dselvan/open-sassy/README.md

# open-sassy
design and implementation of a slip angle sensor targeted for formula student electric controls applications
