dselvan/open-sassy/docs/notes.md

# Notes for documentation setup

- <https://learn.adafruit.com/the-well-automated-arduino-library/doxygen>
