dselvan/open-sassy/sensor_capture/img/white_a4_squal54.png

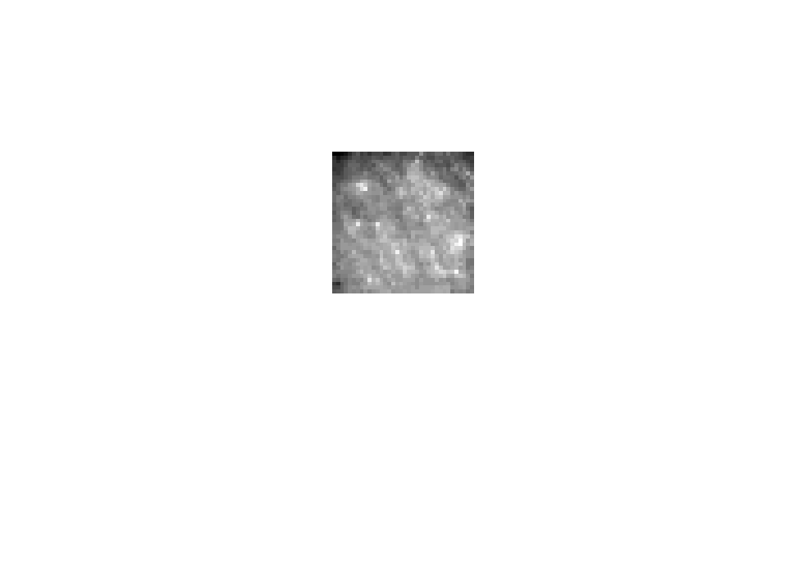
sensor_capture/img/white_a4_squal54.png
