dselvan/open-sassy/pcb_design/optical_sensor_daughter_board/optical_sensor_daughter_board.step

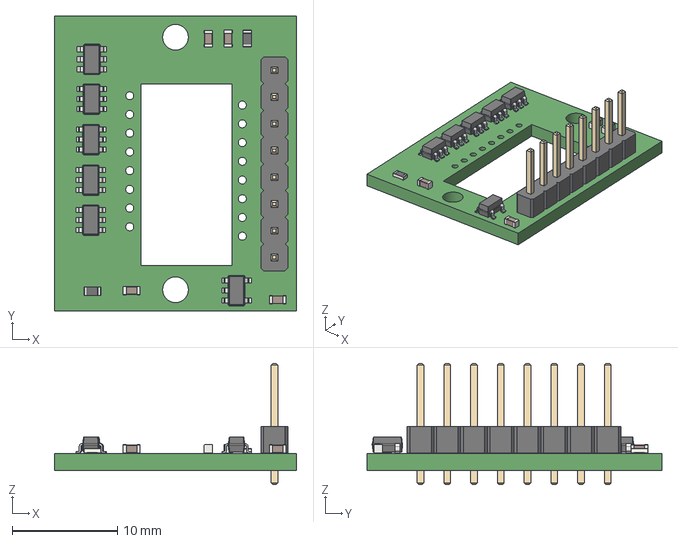
[picture p3: CAD file, 2019-09-04]
pcb_design/optical_sensor_daughter_board/optical_sensor_daughter_board.step
23.0 x 28.0 x 11.5 mm
