dselvan/open-sassy/test/README.md

# Unit Tests

Collection of unit tests for calculation and transformation classes.

Note: Can't test classes that use Arduino libs.
