dselvan/open-sassy/pcb_design/optical_sensor_daughter_board/optical_sensor_daughter_board.pdf

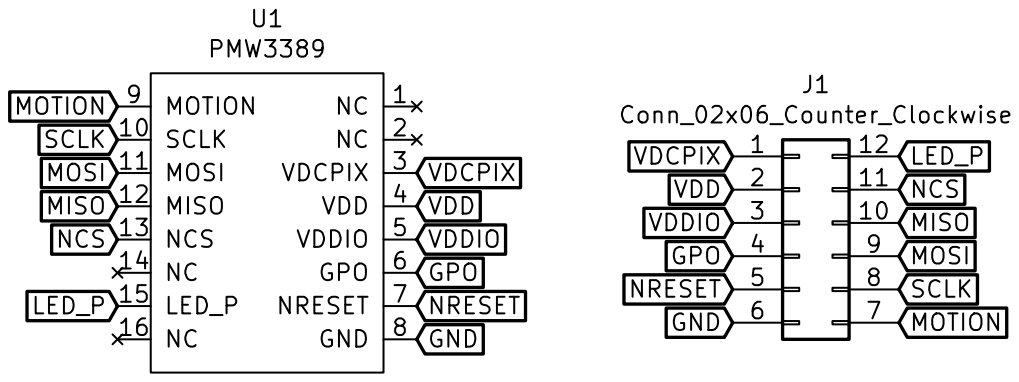
[picture p4: page 1]

LED_P NCS MISO MOSI SCLK MOTION
