dselvan/open-sassy/pcb_design/optical_sensor_daughter_board/hand_plots/os_daughter_board_hand_etch-B_Cu.pdf

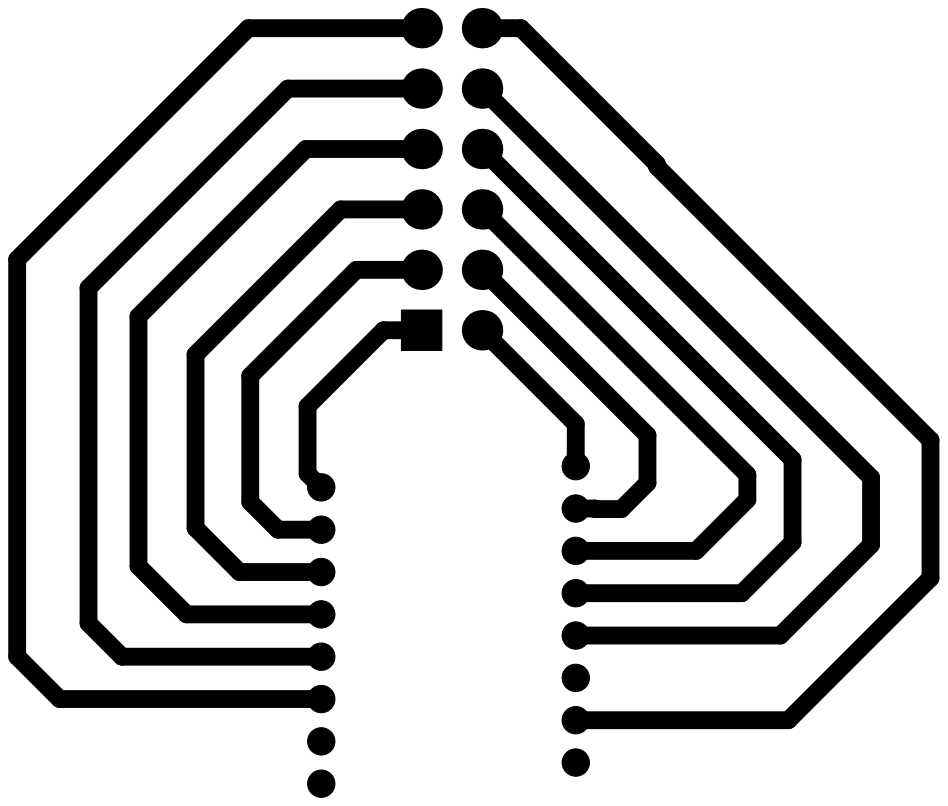
[picture p5: page 1]
