dselvan/open-sassy/(list of files, drawings)

Other design files:
pcb_design/optical_sensor_daughter_board/optical_sensor_daughter_board.dsn
