dselvan/open-sassy/pcb_design/optical_sensor_daughter_board/optical_sensor_daughter_board.kicad_pcb

## KiCad design pcb_design/optical_sensor_daughter_board/optical_sensor_daughter_board.kicad_pcb (2019-09-05)

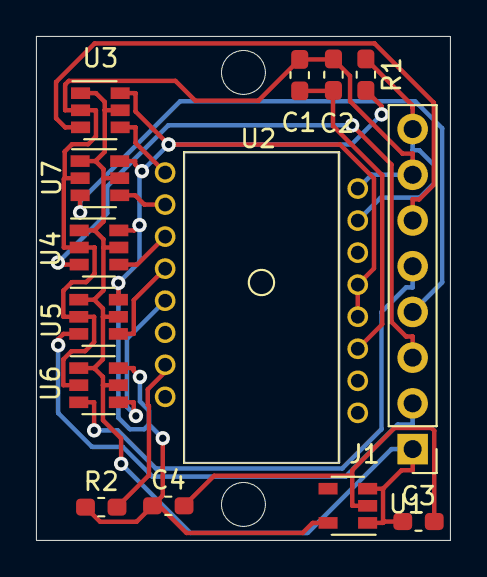
[picture p6: board optical_sensor_daughter_board.kicad_pcb from above]

Board: 2 copper layers, 23.0 x 28.0 mm, 14 parts (0 on the bottom side), 17 nets.

Parts:
C1: 0.1uF; C_0603_1608Metric_Pad1.05x0.95mm_HandSolder
C2: 4.7uF; C_0603_1608Metric_Pad1.05x0.95mm_HandSolder
C3, C4: 1uF; C_0603_1608Metric_Pad1.05x0.95mm_HandSolder
J1: Conn_01x08_Male; PinHeader_1x08_P2.54mm_Vertical
R1: 10K; R_0603_1608Metric_Pad1.05x0.95mm_HandSolder
R2: 39; R_0603_1608Metric_Pad1.05x0.95mm_HandSolder
U1: TLV70019_SOT23-5; SOT-23-5
U2: PMW3360; PMW3389
U3, U4, U5, U6, U7: SN74LVC1T45DBV; SOT-23-6

Connections:
GND: C1.1, C2.1, J1.7, U2.8, U3.2, U4.2, U5.2, U6.2, U7.2
MISO: U2.12, U5.4
MISO_3.3V: J1.2, U5.3
MOIS_3.3V: J1.3, U4.3
MOSI: U2.11, U4.4
MOTION: U2.9, U3.4
MOTION_3.3V: J1.6, U3.3
unnamed: C1.2, C2.2, U2.3
unnamed: C3.2, C4.2, U1.2
unnamed: R2.2, U2.15
RESET: J1.8, R1.1, U2.7
SCLK: U2.10, U7.4
SLCK_3.3V: J1.4, U7.3
SS: U2.13, U6.4
SS_3.3V: J1.5, U6.3
VDD: C4.1, R1.2, R2.1, U1.5, U2.4, U2.5, U3.6, U4.6, U5.6, U6.6, U7.6
VIN: C3.1, J1.1, U1.1, U1.3, U3.1, U3.5, U4.1, U4.5, U5.1, U5.5, U6.1, U6.5, U7.1, U7.5
