dselvan/open-sassy/src/PMW3360Firmware_v08.h

#ifndef _PMW3360Firmware_V08_
#define _PMW3360Firmware_V08_

#include <avr/pgmspace.h>

// Firmware "PMW3360DM_srom_0x08"

const unsigned short firmware_length = 4094;

const unsigned char firmware_data[] PROGMEM = {
    0x01, 0x03, 0x87, 0x8a, 0x56, 0x0f, 0xde, 0x3e, 0xfe, 0x5f, 0x1d, 0xb8, 0xf2, 0x66, 0x4e, 0xff, 0x7c, 0x7a, 0x76, 0x4e, 0x1c, 0xb8, 0xd7, 0x0d, 0x79, 0x70, 0x62, 0x27, 0xcc, 0x1a, 0xb6, 0xee, 0x3f, 0xfc, 0x7a, 0x76, 0x4f, 0x1c, 0x9b, 0xb4, 0xcb, 0xf5, 0x49, 0x10, 0x83, 0x84, 0x8a, 0x96, 0x8f, 0x7d, 0x78, 0x72, 0x66, 0x4d, 0x1e, 0xbe, 0xdf, 0x1d, 0x99, 0xb0, 0xe2, 0x46, 0x0e, 0x9e, 0xbe, 0xfe, 0x7e, 0x7e, 0x7e, 0x7e, 0x5f, 0x1d, 0xbc, 0xf2, 0x47, 0x0c, 0x9a, 0xb6, 0xcf, 0x1c, 0x9b, 0xb4, 0xcb, 0xf5, 0x49, 0x10, 0x83, 0x65, 0x48, 0x12, 0x87, 0x6d, 0x58, 0x32, 0xc7, 0x0c, 0x9a, 0xb6, 0xcf, 0x1c, 0xba, 0xf6, 0x6e, 0x5e, 0x1f, 0xbc, 0xdb, 0x34, 0xcb, 0x14, 0x8b, 0x94, 0xaa, 0xb7, 0xcd, 0xf9, 0x70, 0x43, 0x04, 0xb7, 0x71, 0xbc, 0xbb, 0x4d, 0x30, 0x19, 0x01, 0x73, 0x3f, 0xd7, 0xb9, 0x00, 0x10, 0x96, 0xcd, 0x16, 0xd5, 0x5f, 0xed, 0x63, 0x14, 0xf7, 0x61, 0x6a, 0x4e, 0xb3, 0x8e, 0x70, 0x6e, 0x79, 0x9a, 0x51, 0x24, 0xb4, 0xc7, 0xca, 0x58, 0x33, 0xee, 0x94, 0xc1, 0x2e, 0x50, 0x4c, 0xec, 0x74, 0x6c, 0x4b, 0xe4, 0x5a, 0xf0, 0xbb, 0xb0, 0xba, 0x38, 0x06, 0xf7, 0x9b, 0xac, 0xde, 0x47, 0xc2, 0xf7, 0x3e, 0xa7, 0x4a, 0x33, 0x9d, 0x97, 0x3d, 0x89, 0x9d, 0xf7, 0x28, 0x8a, 0xb2, 0x44, 0x44, 0x49, 0xae, 0xe1, 0xf9, 0xeb, 0x36, 0xd2, 0x5d, 0x43, 0x85, 0x55, 0x88, 0xe8, 0xa9, 0x81, 0xea, 0xf7, 0x52, 0x7d, 0xd4, 0x88, 0x07, 0xda, 0xd8, 0xce, 0x3f, 0xe2, 0xed, 0x6e, 0x7f, 0x28, 0x85, 0x6f, 0xad, 0xdd, 0xf1, 0xf4, 0x23, 0x6b, 0xdd, 0x7c, 0x33, 0x03, 0xb8, 0x2b, 0x5c, 0x33, 0xf9, 0x49, 0x0e, 0x70, 0x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
48, 0x12, 0x87, 0x6d, 0x39, 0xd1, 0x01, 0x80, 0x82, 0x86, 0x6f, 0x5c, 0x1b, 0xb4, 0xcb, 0xf5, 0x68, 0x33, 0xe4, 0x4a, 0x16, 0x8f, 0x7d, 0x78, 0x53, 0x24, 0xab, 0xb5, 0xe8, 0x33, 0xe4, 0x4a, 0xf7, 0x6c, 0x5a, 0x17, 0xac, 0xbb, 0xd5, 0x28, 0xb3, 0xc5, 0x08, 0x92, 0x87, 0x6d, 0x39, 0xd1, 0x20, 0xa3, 0xa5, 0xc8, 0x12, 0xa6, 0xaf, 0xdc, 0x1b, 0xb4, 0xcb, 0x14, 0xaa, 0xb7, 0xcd, 0x18, 0x93, 0x85, 0x69, 0x50, 0x03, 0x65, 0x29, 0xb1, 0xc1, 0x00, 0x82, 0x86, 0x6f, 0x3d, 0xd9, 0x30, 0xc3, 0x04, 0x6b, 0x35, 0xe8, 0x33, 0xe4, 0x2b, 0xd4, 0x0b, 0x75, 0xa9, 0x6b, 0xbb, 0xff};

#endif
