dselvan/open-sassy/(commit log)

2019-05-12 Create notes.md
    Add link for arduino documentation generation
2019-06-20 Add inital pcb design for optical sensor daughter board
    [optical_sensor_daughter_board.kicad_pcb, optical_sensor_daughter_board.sch]
2019-06-26 Working commit that needs to be refeactored
    [os_daughter_board_hand_etch.kicad_pcb]
2019-08-03 Initial code to read from optical sensor based on mrjohnk's code
2019-08-05 Add simple threading lib
2019-08-20 sensor capture
2019-08-23 wip calc slip angle
    [OpticalSensor.cpp, OpticalSensor.h, SignalProcessing.cpp, SignalProcessing.h, SlipAngle.cpp, SlipAngle.h, main.cpp]
2019-09-04 WIP daughter board
    [optical_sensor_daughter_board.dsn, optical_sensor_daughter_board.kicad_pcb, optical_sensor_daughter_board.step]
2019-09-05 New 0x08 firmware added
    [bom.csv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]
